yisea123/WK_JZQ_V2.7/doc/蜂鸣器播放旋律编写说明.txt

每一个音符用大括号括起来，第一个参数表示音高，第二个参数表示音长，中间用逗号隔开
如：{3,1/1},表示音调是3，音长是一个节拍
如：{2,1/4},表示音调是2，音长是四分之一个节拍，最短支持八分之一个节拍
支持一个高8度和一个低8度
如：{1~,2/1},表示音调是高音1，音长是两个节拍
如：{7_,3/4},表示音调是低音7，音长是四分之三个节拍
支持停顿，
如：{0,1/1},表示停顿一个节拍

本文件夹中"beep.txt"文件是蜂鸣器音乐的示例文件
把该文件复制到SD卡的根目录下
用脚本调用 run_beep("0:/beep.txt") 即可播放月光
用脚本调用 run_beep("0:/weizhuang.txt") 即可播放伪装
用脚本调用 run_beep("0:/juhuatai.txt") 即可播放菊花台
