yisea123/WK_JZQ_V2.7/doc/温控集中器.pdf

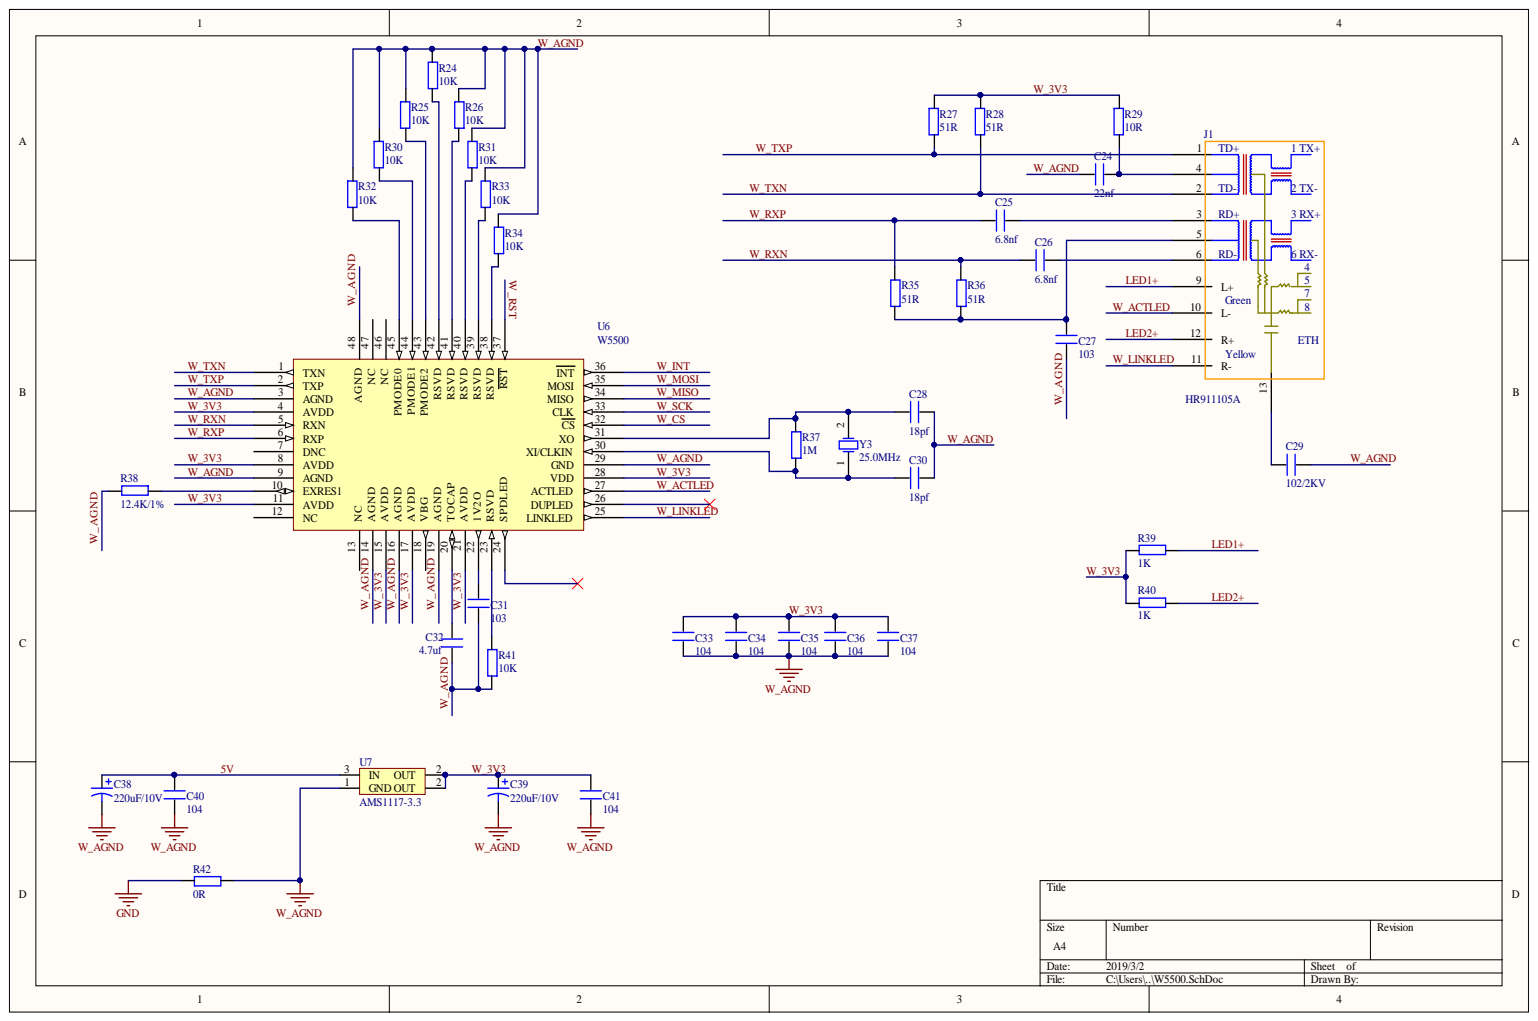
[picture p1: page 1]

6 | RD-

LED1+ W_ACTLED | | L+ 9 L- 10 R+ 12 R- 11 | 4

RST 37 RSVD 38 RSVD 39 RSVD 40 RSVD 41 RSVD 42 PMODE2 43 PMODE1 44 PMODE0 45 NC 46 NC 47 AGND 48

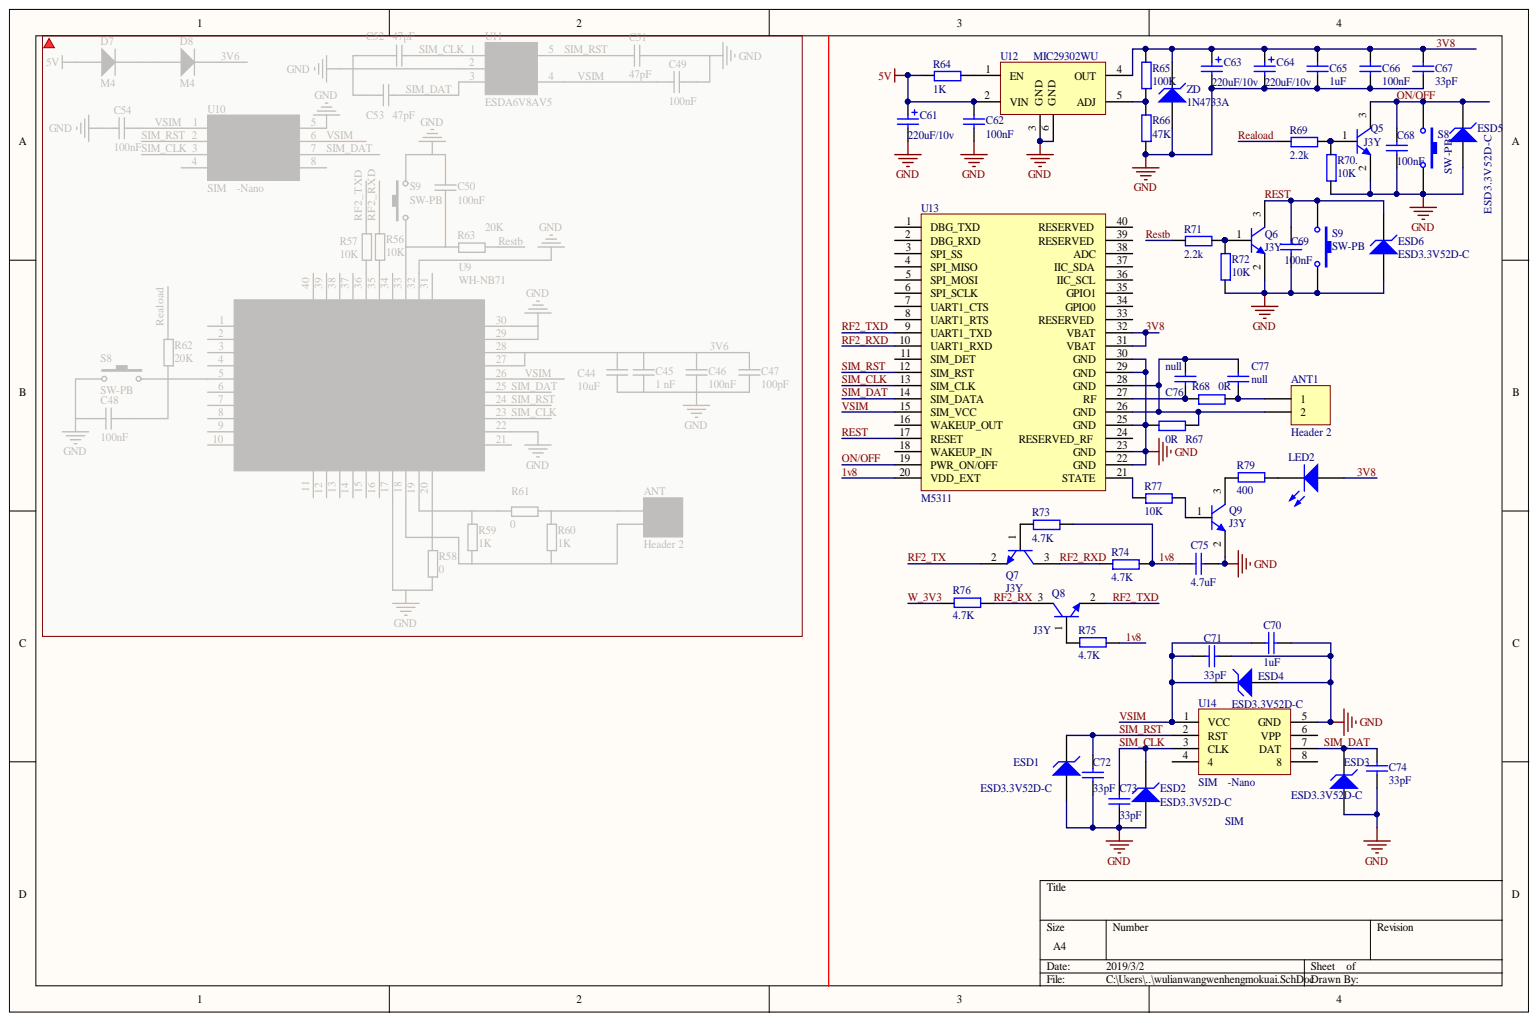
[picture p2: page 2]

2 2 | VSIM | C49

U9
WH-NB71 GND

PIO11 4 | | VSIM | C45 | C46

PIO20 6
PIO21 7 | SIM_RST
NC 8 | SIM_CLK

33pF ESD4

U14 ESD3.3V52D-C

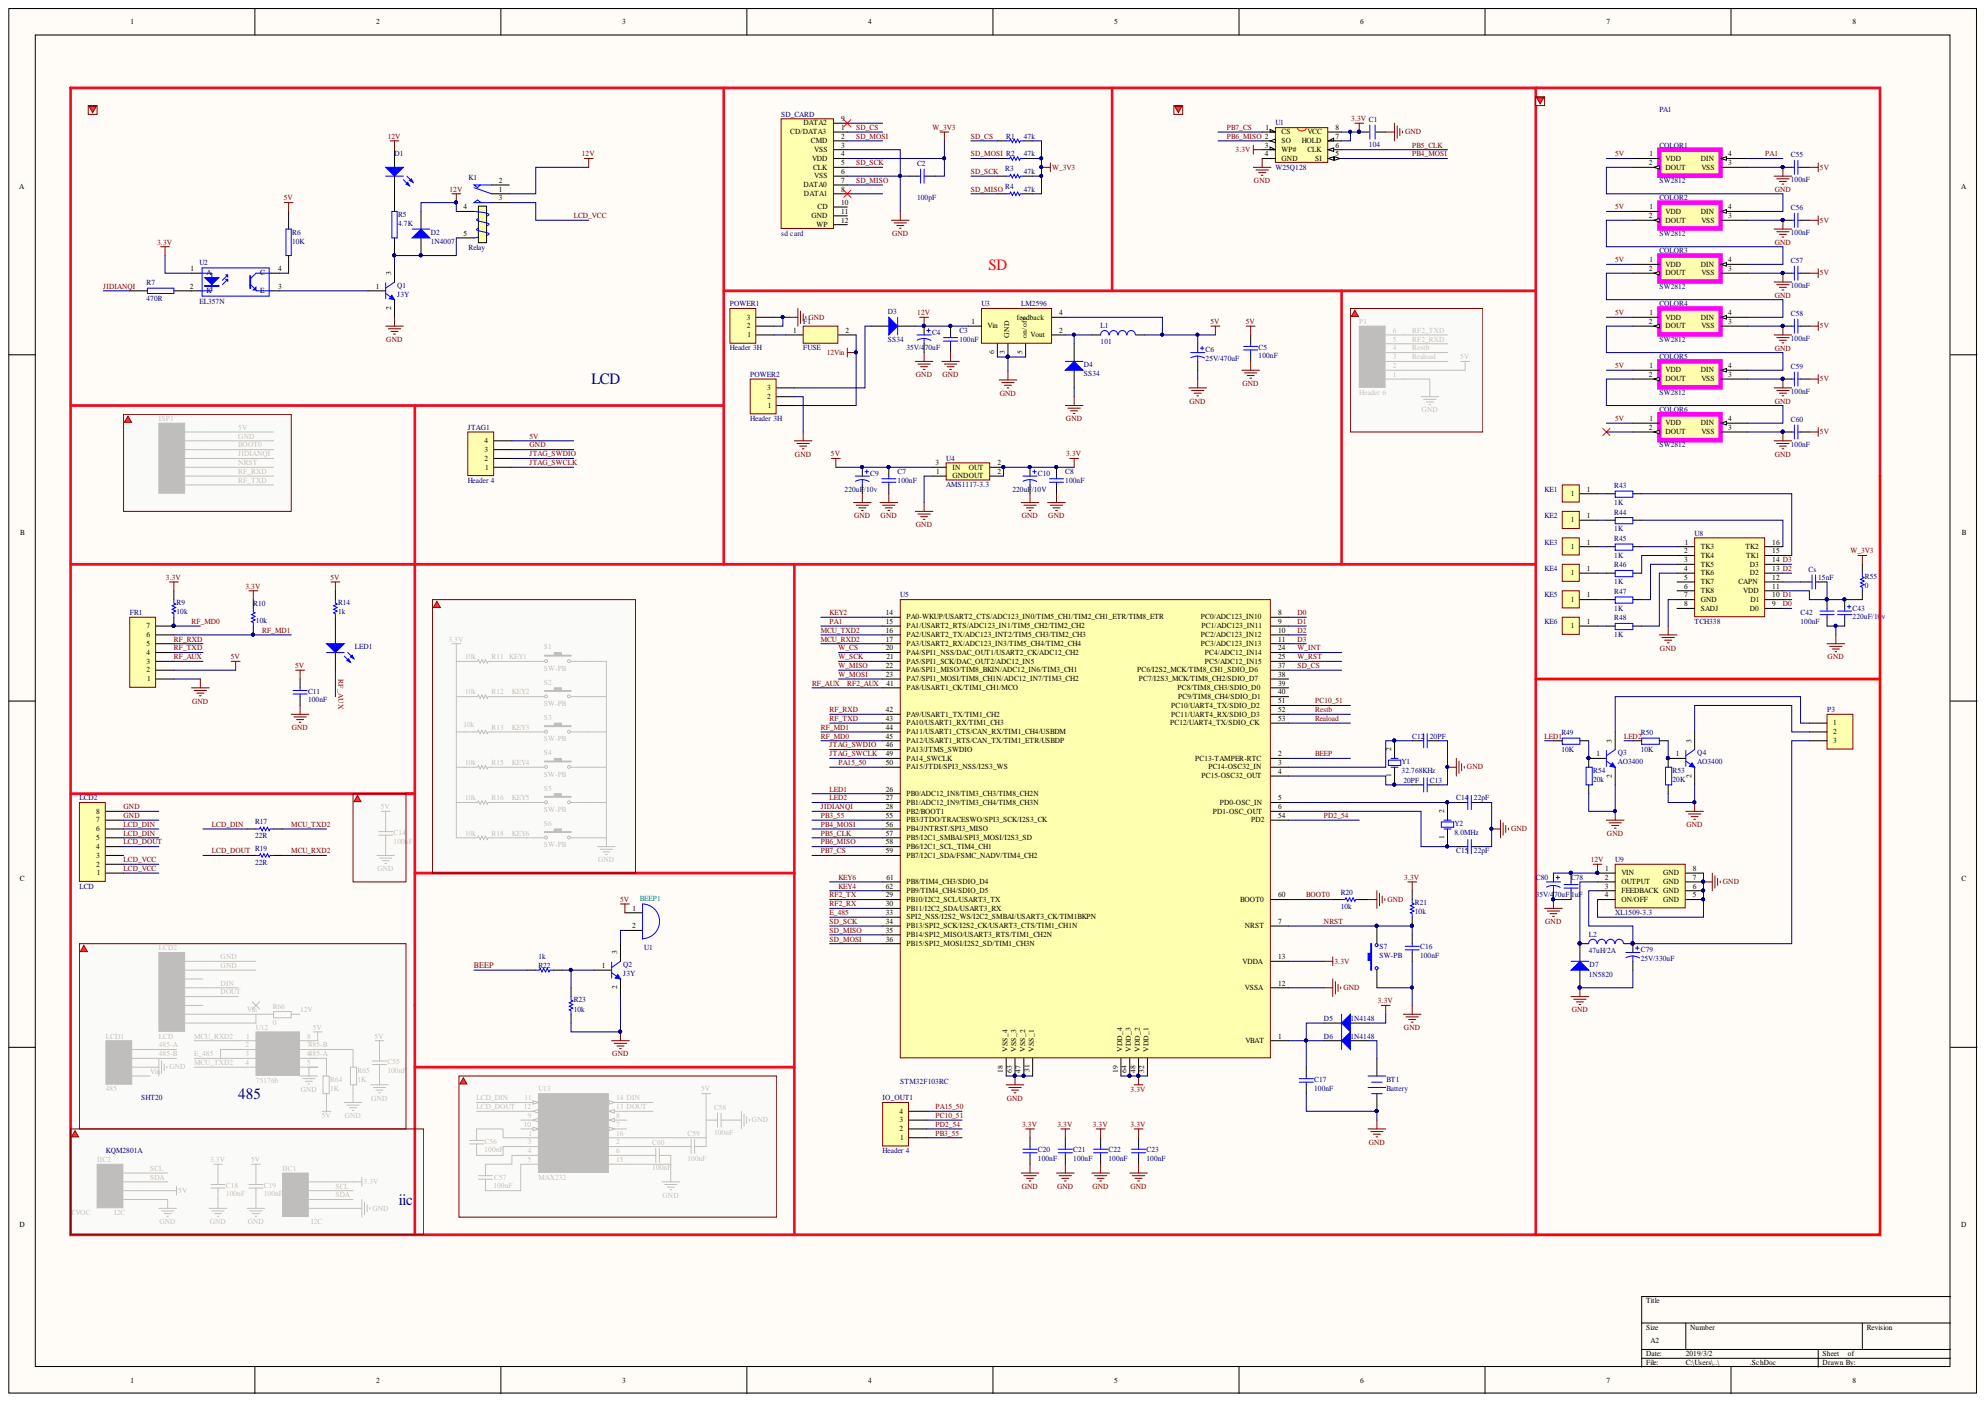
[picture p3: page 3]

TK4 2
TK5 3 | D3 D2

GND 7 | D1
