yisea123/WK_JZQ_V2.7/HARDWARE/W5500/W5500.c

/**********************************************************************************
 * 文件名  ：W5500.c
 * 描述    ：W5500 驱动函数库         
 * 库版本  ：ST_v3.5
 * 更新说明：重新整理网络部分，这个文件只提供硬件操作，2018.12.7
 * 中断优先级：2,2
 * 淘宝    ：http://yixindianzikeji.taobao.com/
**********************************************************************************/
#include "includes.h"
#include "hard_irq.h"
#include "W5500.h"	



/***************----- 网络参数变量定义 -----***************/

u8 Phy_Addr[6]={0};//硬件地址

/***************----- 端口的运行模式 -----***************/
#define TCP_SERVER	0x00	//TCP服务器模式
#define TCP_CLIENT	0x01	//TCP客户端模式 
#define UDP_MODE	0x02	//UDP(广播)模式 

/***************----- 端口的运行状态 -----***************/
#define S_INIT		0x01	//端口完成初始化 
#define S_CONN		0x02	//端口完成连接,可以正常传输数据 

/***************----- 端口收发数据的状态 -----***************/
#define S_RECEIVE	 0x01	//端口接收到一个数据包 
#define S_TRANSMITOK 0x02	//端口发送一个数据包完成 

/***************----- 端口数据缓冲区 -----***************/


/*******************************************************************************
* 函数名  : W5500_GPIO_Configuration
* 描述    : W5500 GPIO初始化配置
* 输入    : 无
* 输出    : 无
* 返回值  : 无
* 说明    : 无
*******************************************************************************/
void W5500_GPIO_Configuration(void)
{
	OS_ENTER_ONLYME();
	GPIO_InitTypeDef  GPIO_InitStructure;
	EXTI_InitTypeDef  EXTI_InitStructure;	
	NVIC_InitTypeDef NVIC_InitStructure;

	/* W5500_RST引脚初始化配置(PC5) */
	GPIO_InitStructure.GPIO_Pin  = W5500_RST;
	GPIO_InitStructure.GPIO_Speed=GPIO_Speed_10MHz;
	GPIO_InitStructure.GPIO_Mode = GPIO_Mode_Out_PP;
	GPIO_Init(W5500_RST_PORT, &GPIO_InitStructure);
	GPIO_ResetBits(W5500_RST_PORT, W5500_RST);
	
	/* W5500_INT引脚初始化配置(PC4) */	
	GPIO_InitStructure.GPIO_Pin = W5500_INT;
	GPIO_InitStructure.GPIO_Speed=GPIO_Speed_50MHz;
	GPIO_InitStructure.GPIO_Mode = GPIO_Mode_IPU;
	GPIO_Init(W5500_INT_PORT, &GPIO_InitStructure);
		
	/* Connect EXTI Line4 to PC4 */
	GPIO_EXTILineConfig(GPIO_PortSourceGPIOC, GPIO_PinSource4);

	/* PC4 as W5500 interrupt input */
	EXTI_InitStructure.EXTI_Line = EXTI_Line4;
	EXTI_InitStructure.EXTI_Mode = EXTI_Mode_Interrupt;
	EXTI_InitStructure.EXTI_Trigger = EXTI_Trigger_Falling;
	EXTI_InitStructure.EXTI_LineCmd = ENABLE;
	EXTI_Init(&EXTI_InitStructure);
	NVIC_InitStructure.NVIC_IRQChannel = EXTI4_IRQn;			//使能按键WK_UP所在的外部中断通道
	NVIC_InitStructure.NVIC_IRQChannelPreemptionPriority = 0x02;	//抢占优先级2， 
	NVIC_InitStructure.NVIC_IRQChannelSubPriority = 0x02;					//子优先级3
	NVIC_InitStructure.NVIC_IRQChannelCmd = ENABLE;								//使能外部中断通道
	NVIC_Init(&NVIC_InitStructure); 
	OS_EXIT_ONLYME();
}

/*******************************************************************************
* 函数名  : W5500_NVIC_Configuration
* 描述    : W5500 接收引脚中断优先级设置
* 输入    : 无
* 输出    : 无
* 返回值  : 无
* 说明    : 无
*******************************************************************************/
void W5500_NVIC_Configuration(void)
{
  	NVIC_InitTypeDef NVIC_InitStructure;

	/* Enable the EXTI4 Interrupt */
	NVIC_InitStructure.NVIC_IRQChannel = EXTI4_IRQn;
	NVIC_InitStructure.NVIC_IRQChannelPreemptionPriority = 0;
	NVIC_InitStructure.NVIC_IRQChannelSubPriority = 1;
	NVIC_InitStructure.NVIC_IRQChannelCmd = ENABLE;
	NVIC_Init(&NVIC_InitStructure);
}

/*******************************************************************************
* 函数名  : EXTI4_IRQHandler
* 描述    : 中断线4中断服务函数(W5500 INT引脚中断服务函数)
* 输入    : 无
* 输出    : 无
* 返回值  : 无
* 说明    : 无

				2018.7.31 中断函数移到了my_w5500.c文件中
*******************************************************************************/

/*******************************************************************************
* 函数名  : SPI_Configuration
* 描述    : W5500 SPI初始化配置(STM32 SPI1)
* 输入    : 无
* 输出    : 无
* 返回值  : 无
* 说明    : 无
*******************************************************************************/
void SPI_Configuration(void)
{
	GPIO_InitTypeDef 	GPIO_InitStructure;
	SPI_InitTypeDef   	SPI_InitStructure;	   

  RCC_APB2PeriphClockCmd(RCC_APB2Periph_GPIOA | RCC_APB2Periph_SPI1 | RCC_APB2Periph_AFIO, ENABLE);	

	/* 初始化SCK、MISO、MOSI引脚 */
	GPIO_InitStructure.GPIO_Pin = GPIO_Pin_5 | GPIO_Pin_6 | GPIO_Pin_7;
	GPIO_InitStructure.GPIO_Speed = GPIO_Speed_50MHz;
	GPIO_InitStructure.GPIO_Mode = GPIO_Mode_AF_PP;
	GPIO_Init(GPIOA, &GPIO_InitStructure);
	GPIO_SetBits(GPIOA,GPIO_Pin_5|GPIO_Pin_6|GPIO_Pin_7);

	/* 初始化CS引脚 */
	GPIO_InitStructure.GPIO_Pin = W5500_SCS;
	GPIO_InitStructure.GPIO_Speed=GPIO_Speed_50MHz;
	GPIO_InitStructure.GPIO_Mode=GPIO_Mode_Out_PP;
	GPIO_Init(W5500_SCS_PORT, &GPIO_InitStructure);
	GPIO_SetBits(W5500_SCS_PORT, W5500_SCS);

	/* 初始化配置STM32 SPI1 */
	SPI_InitStructure.SPI_Direction=SPI_Direction_2Lines_FullDuplex;	//SPI设置为双线双向全双工
	SPI_InitStructure.SPI_Mode=SPI_Mode_Master;							//设置为主SPI
	SPI_InitStructure.SPI_DataSize=SPI_DataSize_8b;						//SPI发送接收8位帧结构
	SPI_InitStructure.SPI_CPOL=SPI_CPOL_Low;							//时钟悬空低
	SPI_InitStructure.SPI_CPHA=SPI_CPHA_1Edge;							//数据捕获于第1个时钟沿
	SPI_InitStructure.SPI_NSS=SPI_NSS_Soft;								//NSS由外部管脚管理
	SPI_InitStructure.SPI_BaudRatePrescaler=SPI_BaudRatePrescaler_2;	//波特率预分频值为2
	SPI_InitStructure.SPI_FirstBit=SPI_FirstBit_MSB;					//数据传输从MSB位开始
	SPI_InitStructure.SPI_CRCPolynomial=7;								//CRC多项式为7
	SPI_Init(SPI1,&SPI_InitStructure);									//根据SPI_InitStruct中指定的参数初始化外设SPI1寄存器

	SPI_Cmd(SPI1,ENABLE);	//STM32使能SPI1
}

/*******************************************************************************
* 函数名  : SPI1_Send_Byte
* 描述    : SPI1发送1个字节数据
* 输入    : dat:待发送的数据
* 输出    : 无
* 返回值  : 返回读取到的值
* 说明    : 无
*******************************************************************************/
u8 SPI1_Send_Byte(unsigned char dat)
{
	u8 retry=0;				 	
	u8 ret=0;
	OS_ENTER_ONLYME();
	while (SPI_I2S_GetFlagStatus(SPI1, SPI_I2S_FLAG_TXE) == RESET) //检查指定的SPI标志位设置与否:发送缓存空标志位
	{
		retry++;
		if(retry>200)
		{
			OS_EXIT_ONLYME();
			return 0;
		}
	}			  
	SPI_I2S_SendData(SPI1, dat); //通过外设SPIx发送一个数据
	retry=0;

	while (SPI_I2S_GetFlagStatus(SPI1, SPI_I2S_FLAG_RXNE) == RESET) //检查指定的SPI标志位设置与否:接受缓存非空标志位
	{
		retry++;
		if(retry>200)
		{
			OS_EXIT_ONLYME();
			return 0;
		}
	}	  		
	ret=SPI_I2S_ReceiveData(SPI1); //返回通过SPIx最近接收的数据					    				    
	OS_EXIT_ONLYME();
	return ret;
}

/*******************************************************************************
* 函数名  : SPI1_Send_Short
* 描述    : SPI1发送2个字节数据(16位)
* 输入    : dat:待发送的16位数据
* 输出    : 无
* 返回值  : 无
* 说明    : 无
*******************************************************************************/
void SPI1_Send_Short(unsigned short dat)
{
	OS_ENTER_ONLYME();
	SPI1_Send_Byte(dat/256);//写数据高位
	SPI1_Send_Byte(dat);	//写数据低位
	OS_EXIT_ONLYME();
}

/*******************************************************************************
* 函数名  : Write_W5500_1Byte
* 描述    : 通过SPI1向指定地址寄存器写1个字节数据
* 输入    : reg:16位寄存器地址,dat:待写入的数据
* 输出    : 无
* 返回值  : 无
* 说明    : 无
*******************************************************************************/
void Write_W5500_1Byte(unsigned short reg, unsigned char dat)
{
	OS_ENTER_ONLYME();
	GPIO_ResetBits(W5500_SCS_PORT, W5500_SCS);//置W5500的SCS为低电平

	SPI1_Send_Short(reg);//通过SPI1写16位寄存器地址
	SPI1_Send_Byte(FDM1|RWB_WRITE|COMMON_R);//通过SPI1写控制字节,1个字节数据长度,写数据,选择通用寄存器
	SPI1_Send_Byte(dat);//写1个字节数据

	GPIO_SetBits(W5500_SCS_PORT, W5500_SCS); //置W5500的SCS为高电平
	OS_EXIT_ONLYME();
}

/*******************************************************************************
* 函数名  : Write_W5500_2Byte
* 描述    : 通过SPI1向指定地址寄存器写2个字节数据
* 输入    : reg:16位寄存器地址,dat:16位待写入的数据(2个字节)
* 输出    : 无
* 返回值  : 无
* 说明    : 无
*******************************************************************************/
void Write_W5500_2Byte(unsigned short reg, unsigned short dat)
{
	OS_ENTER_ONLYME();
	GPIO_ResetBits(W5500_SCS_PORT, W5500_SCS);//置W5500的SCS为低电平
		
	SPI1_Send_Short(reg);//通过SPI1写16位寄存器地址
	SPI1_Send_Byte(FDM2|RWB_WRITE|COMMON_R);//通过SPI1写控制字节,2个字节数据长度,写数据,选择通用寄存器
	SPI1_Send_Short(dat);//写16位数据

	GPIO_SetBits(W5500_SCS_PORT, W5500_SCS); //置W5500的SCS为高电平
	OS_EXIT_ONLYME();
}

/*******************************************************************************
* 函数名  : Write_W5500_nByte
* 描述    : 通过SPI1向指定地址寄存器写n个字节数据
* 输入    : reg:16位寄存器地址,*dat_ptr:待写入数据缓冲区指针,size:待写入的数据长度
* 输出    : 无
* 返回值  : 无
* 说明    : 无
*******************************************************************************/
void Write_W5500_nByte(unsigned short reg, unsigned char *dat_ptr, unsigned short size)
{
	unsigned short i;

	OS_ENTER_ONLYME();
	GPIO_ResetBits(W5500_SCS_PORT, W5500_SCS);//置W5500的SCS为低电平	
		
	SPI1_Send_Short(reg);//通过SPI1写16位寄存器地址
	SPI1_Send_Byte(VDM|RWB_WRITE|COMMON_R);//通过SPI1写控制字节,N个字节数据长度,写数据,选择通用寄存器

	for(i=0;i<size;i++)//循环将缓冲区的size个字节数据写入W5500
	{
		SPI1_Send_Byte(*dat_ptr++);//写一个字节数据
	}

	GPIO_SetBits(W5500_SCS_PORT, W5500_SCS); //置W5500的SCS为高电平
	OS_EXIT_ONLYME();
}

/*******************************************************************************
* 函数名  : Write_W5500_SOCK_1Byte
* 描述    : 通过SPI1向指定端口寄存器写1个字节数据
* 输入    : s:端口号,reg:16位寄存器地址,dat:待写入的数据
* 输出    : 无
* 返回值  : 无
* 说明    : 无
*******************************************************************************/
void Write_W5500_SOCK_1Byte(SOCKET s, unsigned short reg, unsigned char dat)
{ 
	OS_ENTER_ONLYME();
	GPIO_ResetBits(W5500_SCS_PORT, W5500_SCS);//置W5500的SCS为低电平	
		
	SPI1_Send_Short(reg);//通过SPI1写16位寄存器地址
	SPI1_Send_Byte(FDM1|RWB_WRITE|(s*0x20+0x08));//通过SPI1写控制字节,1个字节数据长度,写数据,选择端口s的寄存器
	SPI1_Send_Byte(dat);//写1个字节数据

	GPIO_SetBits(W5500_SCS_PORT, W5500_SCS); //置W5500的SCS为高电平
	OS_EXIT_ONLYME();
}

/*******************************************************************************
* 函数名  : Write_W5500_SOCK_2Byte
* 描述    : 通过SPI1向指定端口寄存器写2个字节数据
* 输入    : s:端口号,reg:16位寄存器地址,dat:16位待写入的数据(2个字节)
* 输出    : 无
* 返回值  : 无
* 说明    : 无
*******************************************************************************/
void Write_W5500_SOCK_2Byte(SOCKET s, unsigned short reg, unsigned short dat)
{
	OS_ENTER_ONLYME();
	GPIO_ResetBits(W5500_SCS_PORT, W5500_SCS);//置W5500的SCS为低电平
			
	SPI1_Send_Short(reg);//通过SPI1写16位寄存器地址
	SPI1_Send_Byte(FDM2|RWB_WRITE|(s*0x20+0x08));//通过SPI1写控制字节,2个字节数据长度,写数据,选择端口s的寄存器
	SPI1_Send_Short(dat);//写16位数据

	GPIO_SetBits(W5500_SCS_PORT, W5500_SCS); //置W5500的SCS为高电平
	OS_EXIT_ONLYME();
}

/*******************************************************************************
* 函数名  : Write_W5500_SOCK_4Byte
* 描述    : 通过SPI1向指定端口寄存器写4个字节数据
* 输入    : s:端口号,reg:16位寄存器地址,*dat_ptr:待写入的4个字节缓冲区指针
* 输出    : 无
* 返回值  : 无
* 说明    : 无
*******************************************************************************/
void Write_W5500_SOCK_4Byte(SOCKET s, unsigned short reg, unsigned char *dat_ptr)
{
	OS_ENTER_ONLYME();
	GPIO_ResetBits(W5500_SCS_PORT, W5500_SCS);//置W5500的SCS为低电平
			
	SPI1_Send_Short(reg);//通过SPI1写16位寄存器地址
	SPI1_Send_Byte(FDM4|RWB_WRITE|(s*0x20+0x08));//通过SPI1写控制字节,4个字节数据长度,写数据,选择端口s的寄存器

	SPI1_Send_Byte(*dat_ptr++);//写第1个字节数据
	SPI1_Send_Byte(*dat_ptr++);//写第2个字节数据
	SPI1_Send_Byte(*dat_ptr++);//写第3个字节数据
	SPI1_Send_Byte(*dat_ptr++);//写第4个字节数据

	GPIO_SetBits(W5500_SCS_PORT, W5500_SCS); //置W5500的SCS为高电平
	OS_EXIT_ONLYME();
}

/*******************************************************************************
* 函数名  : Read_W5500_1Byte
* 描述    : 读W5500指定地址寄存器的1个字节数据
* 输入    : reg:16位寄存器地址
* 输出    : 无
* 返回值  : 读取到寄存器的1个字节数据
* 说明    : 无
*******************************************************************************/
unsigned char Read_W5500_1Byte(unsigned short reg)
{
	unsigned char i;

	OS_ENTER_ONLYME();
	GPIO_ResetBits(W5500_SCS_PORT, W5500_SCS);//置W5500的SCS为低电平
			
	SPI1_Send_Short(reg);//通过SPI1写16位寄存器地址
	i=SPI1_Send_Byte(FDM1|RWB_READ|COMMON_R);//通过SPI1写控制字节,1个字节数据长度,读数据,选择通用寄存器

	i=SPI1_Send_Byte(0x00);//发送一个哑数据

	GPIO_SetBits(W5500_SCS_PORT, W5500_SCS);//置W5500的SCS为高电平
	OS_EXIT_ONLYME();
	return i;//返回读取到的寄存器数据
}


/*******************************************************************************
* 函数名  : Read_W5500_nByte
* 描述    : 通过SPI1向指定地址寄存器读n个字节数据
* 输入    : reg:16位寄存器地址,*dat_ptr:待写入数据缓冲区指针,size:待写入的数据长度
* 输出    : 无
* 返回值  : 无
* 说明    : 无
*******************************************************************************/
void Read_W5500_nByte(unsigned short reg, unsigned char *dat_ptr, unsigned short size)
{
	unsigned short i;

	OS_ENTER_ONLYME();
	GPIO_ResetBits(W5500_SCS_PORT, W5500_SCS);//置W5500的SCS为低电平	
		
	SPI1_Send_Short(reg);//通过SPI1写16位寄存器地址
	SPI1_Send_Byte(VDM|RWB_READ|COMMON_R);//通过SPI1写控制字节,N个字节数据长度,写数据,选择通用寄存器

	for(i=0;i<size;i++)//循环将缓冲区的size个字节数据写入W5500
	{
		*dat_ptr++=SPI1_Send_Byte(0);//写一个字节数据
	}

	GPIO_SetBits(W5500_SCS_PORT, W5500_SCS); //置W5500的SCS为高电平
	OS_EXIT_ONLYME();
}

/*******************************************************************************
* 函数名  : Read_W5500_SOCK_1Byte
* 描述    : 读W5500指定端口寄存器的1个字节数据
* 输入    : s:端口号,reg:16位寄存器地址
* 输出    : 无
* 返回值  : 读取到寄存器的1个字节数据
* 说明    : 无
*******************************************************************************/
unsigned char Read_W5500_SOCK_1Byte(SOCKET s, unsigned short reg)
{
	unsigned char i;

	OS_ENTER_ONLYME();
	GPIO_ResetBits(W5500_SCS_PORT, W5500_SCS);//置W5500的SCS为低电平
			
	SPI1_Send_Short(reg);//通过SPI1写16位寄存器地址
	i=SPI1_Send_Byte(FDM1|RWB_READ|(s*0x20+0x08));//通过SPI1写控制字节,1个字节数据长度,读数据,选择端口s的寄存器

	i=SPI1_Send_Byte(0x00);//发送一个哑数据

	GPIO_SetBits(W5500_SCS_PORT, W5500_SCS);//置W5500的SCS为高电平
	OS_EXIT_ONLYME();
	return i;//返回读取到的寄存器数据
}

/*******************************************************************************
* 函数名  : Read_W5500_SOCK_2Byte
* 描述    : 读W5500指定端口寄存器的2个字节数据
* 输入    : s:端口号,reg:16位寄存器地址
* 输出    : 无
* 返回值  : 读取到寄存器的2个字节数据(16位)
* 说明    : 无
*******************************************************************************/
unsigned short Read_W5500_SOCK_2Byte(SOCKET s, unsigned short reg)
{
	unsigned short i;

	OS_ENTER_ONLYME();
	GPIO_ResetBits(W5500_SCS_PORT, W5500_SCS);//置W5500的SCS为低电平
			
	SPI1_Send_Short(reg);//通过SPI1写16位寄存器地址
	i=SPI1_Send_Byte(FDM2|RWB_READ|(s*0x20+0x08));//通过SPI1写控制字节,2个字节数据长度,读数据,选择端口s的寄存器

	i=SPI1_Send_Byte(0x00);//发送一个哑数据
	i<<=8;
	i|=SPI1_Send_Byte(0x00);//发送一个哑数据

	GPIO_SetBits(W5500_SCS_PORT, W5500_SCS);//置W5500的SCS为高电平
	OS_EXIT_ONLYME();
	return i;//返回读取到的寄存器数据
}

/*******************************************************************************
* 函数名  : Read_SOCK_Data_Buffer
* 描述    : 从W5500接收数据缓冲区中读取数据
* 输入    : s:端口号,*dat_ptr:数据保存缓冲区指针
* 输出    : 无
* 返回值  : 读取到的数据长度,rx_size个字节
* 说明    : 无
*******************************************************************************/
unsigned short Read_SOCK_Data_Buffer(SOCKET s, unsigned char *dat_ptr)
{
	unsigned short rx_size;
	unsigned short offset, offset1;
	unsigned short i;
	unsigned char j;
	
	OS_ENTER_ONLYME();

	rx_size=Read_W5500_SOCK_2Byte(s,Sn_RX_RSR);
	if(rx_size==0) 
	{
		OS_EXIT_ONLYME();
		return 0;//没接收到数据则返回
	}
	if(rx_size>1460) rx_size=1460;

	offset=Read_W5500_SOCK_2Byte(s,Sn_RX_RD);
	offset1=offset;
	offset&=(S_RX_SIZE-1);//计算实际的物理地址

	GPIO_ResetBits(W5500_SCS_PORT, W5500_SCS);//置W5500的SCS为低电平

	SPI1_Send_Short(offset);//写16位地址
	j=SPI1_Send_Byte(VDM|RWB_READ|(s*0x20+0x18));//写控制字节,N个字节数据长度,读数据,选择端口s的寄存器
	
	if((offset+rx_size)<S_RX_SIZE)//如果最大地址未超过W5500接收缓冲区寄存器的最大地址
	{
		for(i=0;i<rx_size;i++)//循环读取rx_size个字节数据
		{
			j=SPI1_Send_Byte(0x00);//发送一个哑数据
			*dat_ptr=j;//将读取到的数据保存到数据保存缓冲区
			dat_ptr++;//数据保存缓冲区指针地址自增1
		}
	}
	else//如果最大地址超过W5500接收缓冲区寄存器的最大地址
	{
		offset=S_RX_SIZE-offset;
		for(i=0;i<offset;i++)//循环读取出前offset个字节数据
		{
			j=SPI1_Send_Byte(0x00);//发送一个哑数据
			*dat_ptr=j;//将读取到的数据保存到数据保存缓冲区
			dat_ptr++;//数据保存缓冲区指针地址自增1
		}
		GPIO_SetBits(W5500_SCS_PORT, W5500_SCS); //置W5500的SCS为高电平

		GPIO_ResetBits(W5500_SCS_PORT, W5500_SCS);//置W5500的SCS为低电平

		SPI1_Send_Short(0x00);//写16位地址
		j=SPI1_Send_Byte(VDM|RWB_READ|(s*0x20+0x18));//写控制字节,N个字节数据长度,读数据,选择端口s的寄存器

		for(;i<rx_size;i++)//循环读取后rx_size-offset个字节数据
		{
			j=SPI1_Send_Byte(0x00);//发送一个哑数据
			*dat_ptr=j;//将读取到的数据保存到数据保存缓冲区
			dat_ptr++;//数据保存缓冲区指针地址自增1
		}
	}
	GPIO_SetBits(W5500_SCS_PORT, W5500_SCS); //置W5500的SCS为高电平

	offset1+=rx_size;//更新实际物理地址,即下次读取接收到的数据的起始地址
	Write_W5500_SOCK_2Byte(s, Sn_RX_RD, offset1);
	Write_W5500_SOCK_1Byte(s, Sn_CR, SN_RECV);//发送启动接收命令
	
	OS_EXIT_ONLYME();
	return rx_size;//返回接收到数据的长度
}

/*******************************************************************************
* 函数名  : Write_SOCK_Data_Buffer
* 描述    : 将数据写入W5500的数据发送缓冲区
* 输入    : s:端口号,*dat_ptr:数据保存缓冲区指针,size:待写入数据的长度
* 输出    : 无
* 返回值  : 无
* 说明    : 无
*******************************************************************************/
void Write_SOCK_Data_Buffer(SOCKET s, unsigned char *dat_ptr, unsigned short size)
{
	unsigned short offset,offset1;
	unsigned short i;

	OS_ENTER_ONLYME();

	offset=Read_W5500_SOCK_2Byte(s,Sn_TX_WR);
	offset1=offset;
	offset&=(S_TX_SIZE-1);//计算实际的物理地址

	GPIO_ResetBits(W5500_SCS_PORT, W5500_SCS);//置W5500的SCS为低电平

	SPI1_Send_Short(offset);//写16位地址
	SPI1_Send_Byte(VDM|RWB_WRITE|(s*0x20+0x10));//写控制字节,N个字节数据长度,写数据,选择端口s的寄存器

	if((offset+size)<S_TX_SIZE)//如果最大地址未超过W5500发送缓冲区寄存器的最大地址
	{
		for(i=0;i<size;i++)//循环写入size个字节数据
		{
			SPI1_Send_Byte(*dat_ptr++);//写入一个字节的数据		
		}
		
	}
	else//如果最大地址超过W5500发送缓冲区寄存器的最大地址
	{
		offset=S_TX_SIZE-offset;
		for(i=0;i<offset;i++)//循环写入前offset个字节数据
		{
			SPI1_Send_Byte(*dat_ptr++);//写入一个字节的数据
		}
		GPIO_SetBits(W5500_SCS_PORT, W5500_SCS); //置W5500的SCS为高电平

		GPIO_ResetBits(W5500_SCS_PORT, W5500_SCS);//置W5500的SCS为低电平

		SPI1_Send_Short(0x00);//写16位地址
		SPI1_Send_Byte(VDM|RWB_WRITE|(s*0x20+0x10));//写控制字节,N个字节数据长度,写数据,选择端口s的寄存器

		for(;i<size;i++)//循环写入size-offset个字节数据
		{
			SPI1_Send_Byte(*dat_ptr++);//写入一个字节的数据
		}
	}
	GPIO_SetBits(W5500_SCS_PORT, W5500_SCS); //置W5500的SCS为高电平

	offset1+=size;//更新实际物理地址,即下次写待发送数据到发送数据缓冲区的起始地址
	Write_W5500_SOCK_2Byte(s, Sn_TX_WR, offset1);
	Write_W5500_SOCK_1Byte(s, Sn_CR, SN_SEND);//发送启动发送命令				
	OS_EXIT_ONLYME();
}

/*******************************************************************************
* 函数名  : W5500_Hardware_Reset
* 描述    : 硬件复位W5500
* 输入    : 无
* 输出    : 无
* 返回值  : 无
* 说明    : W5500的复位引脚保持低电平至少500us以上,才能重围W5500
*******************************************************************************/
void W5500_Hardware_Reset(void)
{
	GPIO_ResetBits(W5500_RST_PORT, W5500_RST);//复位引脚拉低
	Delay(500);
	GPIO_SetBits(W5500_RST_PORT, W5500_RST);//复位引脚拉高
	Delay(200);
	while((Read_W5500_1Byte(PHYCFGR)&LINK)==0)
	{
		Delay(200);
		
	}//等待以太网连接完成
}

/*******************************************************************************
* 函数名  : W5500_Init
* 描述    : 初始化W5500寄存器函数
* 输入    : 无
* 输出    : 无
* 返回值  : 无
* 说明    : 在使用W5500之前，先对W5500初始化
*******************************************************************************/
void W5500_Init(void)
{
	u8 i=0;

	Write_W5500_1Byte(MR, RST);//软件复位W5500,置1有效,复位后自动清0
	Delay(10);//延时10ms,自己定义该函数

	//设置MAC地址到W5500
	Write_W5500_nByte(SHAR,Phy_Addr,6);		

	
	//设置发送缓冲区和接收缓冲区的大小，参考W5500数据手册
	for(i=0;i<8;i++)
	{
		Write_W5500_SOCK_1Byte(i,Sn_RXBUF_SIZE, 0x02);//Socket Rx memory size=2k
		Write_W5500_SOCK_1Byte(i,Sn_TXBUF_SIZE, 0x02);//Socket Tx mempry size=2k
	}

	//设置重试时间，默认为2000(200ms) 
	//每一单位数值为100微秒,初始化时值设为2000，等于200毫秒
	Write_W5500_2Byte(RTR, 2000);

	//设置重试次数，默认为8次 
	//如果重发的次数超过设定值,则产生超时中断(相关的端口中断寄存器中的Sn_IR 超时位(TIMEOUT)置“1”)
	Write_W5500_1Byte(RCR,8);

	//启动中断，参考W5500数据手册确定自己需要的中断类型
	//IMR_CONFLICT是IP地址冲突异常中断,IMR_UNREACH是UDP通信时，地址无法到达的异常中断
	//其它是Socket事件中断，根据需要添加
	Write_W5500_1Byte(IMR,IM_IR7 | IM_IR6);
	Write_W5500_1Byte(SIMR,S0_IMR|S1_IMR|S2_IMR|S3_IMR|S4_IMR|S5_IMR|S6_IMR|S7_IMR);
	Write_W5500_SOCK_1Byte(0, Sn_IMR, IMR_SENDOK | IMR_TIMEOUT | IMR_RECV | IMR_DISCON | IMR_CON);
	Write_W5500_SOCK_1Byte(1, Sn_IMR, IMR_SENDOK | IMR_TIMEOUT | IMR_RECV | IMR_DISCON | IMR_CON);
	Write_W5500_SOCK_1Byte(2, Sn_IMR, IMR_SENDOK | IMR_TIMEOUT | IMR_RECV | IMR_DISCON | IMR_CON);
	Write_W5500_SOCK_1Byte(3, Sn_IMR, IMR_SENDOK | IMR_TIMEOUT | IMR_RECV | IMR_DISCON | IMR_CON);
	Write_W5500_SOCK_1Byte(4, Sn_IMR, IMR_SENDOK | IMR_TIMEOUT | IMR_RECV | IMR_DISCON | IMR_CON);
	Write_W5500_SOCK_1Byte(5, Sn_IMR, IMR_SENDOK | IMR_TIMEOUT | IMR_RECV | IMR_DISCON | IMR_CON);
	Write_W5500_SOCK_1Byte(6, Sn_IMR, IMR_SENDOK | IMR_TIMEOUT | IMR_RECV | IMR_DISCON | IMR_CON);
	Write_W5500_SOCK_1Byte(7, Sn_IMR, IMR_SENDOK | IMR_TIMEOUT | IMR_RECV | IMR_DISCON | IMR_CON);
}

/*******************************************************************************
* 函数名  : Socket_Init
* 描述    : 指定Socket(0~7)初始化
* 输入    : s:待初始化的端口
* 输出    : 无
* 返回值  : 无
* 说明    : 无
*******************************************************************************/
void Socket_Init(SOCKET s)
{
	//设置分片长度，参考W5500数据手册，该值可以不修改	
	Write_W5500_SOCK_2Byte(0, Sn_MSSR, 1460);//最大分片字节数=1460(0x5b4)
	Write_W5500_SOCK_2Byte(1, Sn_MSSR, 1460);//最大分片字节数=1460(0x5b4)
	Write_W5500_SOCK_2Byte(2, Sn_MSSR, 1460);//最大分片字节数=1460(0x5b4)
	Write_W5500_SOCK_2Byte(3, Sn_MSSR, 1460);//最大分片字节数=1460(0x5b4)
	Write_W5500_SOCK_2Byte(4, Sn_MSSR, 1460);//最大分片字节数=1460(0x5b4)
	Write_W5500_SOCK_2Byte(5, Sn_MSSR, 1460);//最大分片字节数=1460(0x5b4)
	Write_W5500_SOCK_2Byte(6, Sn_MSSR, 1460);//最大分片字节数=1460(0x5b4)
	Write_W5500_SOCK_2Byte(7, Sn_MSSR, 1460);//最大分片字节数=1460(0x5b4)
}

/*******************************************************************************
* 函数名  : Socket_Connect
* 描述    : 设置指定Socket(0~7)为客户端与远程服务器连接
* 输入    : s:待设定的端口
* 输出    : 无
* 返回值  : 成功返回TRUE(0xFF),失败返回FALSE(0x00)
* 说明    : 当本机Socket工作在客户端模式时,引用该程序,与远程服务器建立连接
*			如果启动连接后出现超时中断，则与服务器连接失败,需要重新调用该程序连接
*			该程序每调用一次,就与服务器产生一次连接
*******************************************************************************/
unsigned char Socket_Connect(SOCKET s)
{
	Write_W5500_SOCK_1Byte(s,Sn_MR,MR_TCP);//设置socket为TCP模式
	Write_W5500_SOCK_1Byte(s,Sn_CR,SN_OPEN);//打开Socket
	Delay(5);//延时5ms
	if(Read_W5500_SOCK_1Byte(s,Sn_SR)!=SOCK_INIT)//如果socket打开失败
	{
		Write_W5500_SOCK_1Byte(s,Sn_CR,SN_CLOSE);//打开不成功,关闭Socket
		return FALSE;//返回FALSE(0x00)
	}
	Write_W5500_SOCK_1Byte(s,Sn_CR,SN_CONNECT);//设置Socket为Connect模式
	return TRUE;//返回TRUE,设置成功
}

/*******************************************************************************
* 函数名  : Socket_Listen
* 描述    : 设置指定Socket(0~7)作为服务器等待远程主机的连接
* 输入    : s:待设定的端口
* 输出    : 无
* 返回值  : 成功返回TRUE(0xFF),失败返回FALSE(0x00)
* 说明    : 当本机Socket工作在服务器模式时,引用该程序,等等远程主机的连接
*			该程序只调用一次,就使W5500设置为服务器模式
*******************************************************************************/
unsigned char Socket_Listen(SOCKET s)
{
	Write_W5500_SOCK_1Byte(s,Sn_MR,MR_TCP);//设置socket为TCP模式 
	Write_W5500_SOCK_1Byte(s,Sn_CR,SN_OPEN);//打开Socket	
	Delay(5);//延时5ms
	if(Read_W5500_SOCK_1Byte(s,Sn_SR)!=SOCK_INIT)//如果socket打开失败
	{
		Write_W5500_SOCK_1Byte(s,Sn_CR,SN_CLOSE);//打开不成功,关闭Socket
		return FALSE;//返回FALSE(0x00)
	}	
	Write_W5500_SOCK_1Byte(s,Sn_CR,SN_LISTEN);//设置Socket为侦听模式	
	Delay(5);//延时5ms
	if(Read_W5500_SOCK_1Byte(s,Sn_SR)!=SOCK_LISTEN)//如果socket设置失败
	{
		Write_W5500_SOCK_1Byte(s,Sn_CR,SN_CLOSE);//设置不成功,关闭Socket
		return FALSE;//返回FALSE(0x00)
	}

	return TRUE;

	//至此完成了Socket的打开和设置侦听工作,至于远程客户端是否与它建立连接,则需要等待Socket中断，
	//以判断Socket的连接是否成功。参考W5500数据手册的Socket中断状态
	//在服务器侦听模式不需要设置目的IP和目的端口号
}

/*******************************************************************************
* 函数名  : Socket_UDP
* 描述    : 设置指定Socket(0~7)为UDP模式
* 输入    : s:待设定的端口
* 输出    : 无
* 返回值  : 成功返回TRUE(0xFF),失败返回FALSE(0x00)
* 说明    : 如果Socket工作在UDP模式,引用该程序,在UDP模式下,Socket通信不需要建立连接
*			该程序只调用一次，就使W5500设置为UDP模式
*******************************************************************************/
unsigned char Socket_UDP(SOCKET s)
{
	Write_W5500_SOCK_1Byte(s,Sn_MR,MR_UDP);//设置Socket为UDP模式*/
	Write_W5500_SOCK_1Byte(s,Sn_CR,SN_OPEN);//打开Socket*/
	Delay(5);//延时5ms
	if(Read_W5500_SOCK_1Byte(s,Sn_SR)!=SOCK_UDP)//如果Socket打开失败
	{
		Write_W5500_SOCK_1Byte(s,Sn_CR,SN_CLOSE);//打开不成功,关闭Socket
		return FALSE;//返回FALSE(0x00)
	}
	else
		return TRUE;

	//至此完成了Socket的打开和UDP模式设置,在这种模式下它不需要与远程主机建立连接
	//因为Socket不需要建立连接,所以在发送数据前都可以设置目的主机IP和目的Socket的端口号
	//如果目的主机IP和目的Socket的端口号是固定的,在运行过程中没有改变,那么也可以在这里设置
}

/*******************************************************************************
* 函数名  : W5500_Interrupt_Process
* 描述    : W5500中断处理程序框架
* 输入    : 无
* 输出    : 无
* 返回值  : 无
* 说明    : 无
*******************************************************************************/



/*******************************************************************************
* 函数名  : Delay
* 描述    : 延时函数(ms)
* 输入    : d:延时系数，单位为毫秒
* 输出    : 无
* 返回    : 无 
* 说明    : 延时是利用Timer2定时器产生的1毫秒的计数来实现的

2018.7.31  改为调用系统延时函数

*******************************************************************************/
void Delay(unsigned int d)
{
	delay_ms(d);
}



/*******************************************************************************
* 函数名  : W5500_Socket_Set
* 描述    : W5500端口初始化配置
* 输入    : 无
* 输出    : 无
* 返回值  : 无
* 说明    : 分别设置4个端口,根据端口工作模式,将端口置于TCP服务器、TCP客户端或UDP模式.
*			从端口状态字节Socket_State可以判断端口的工作情况
*******************************************************************************/
void W5500_Socket_Set(void)
{
}


/*******************************************************************************
* 函数名  : W5500_Initialization
* 描述    : W5500初始货配置
* 输入    : 无
* 输出    : 无
* 返回值  : 无
* 说明    : 无
*******************************************************************************/
void W5500_Initialization(void)
{
	SPI_Configuration();		//W5500 SPI初始化配置(STM32 SPI1)
	W5500_GPIO_Configuration();	//W5500 GPIO初始化配置	
	Load_Net_Parameters();		//装载MAC地址到内存
	W5500_Hardware_Reset();		//硬件复位W5500

	W5500_Init();		//初始化W5500寄存器函数，设置MAC地址等
	Socket_Init(0);		//初始化Socket参数，端口的数据分片
}








/*******************************************************************************
* 函数名  : Load_Net_Parameters
* 描述    : 装载网络参数
* 输入    : 无
* 输出    : 无
* 返回值  : 无
* 说明    : 网关、掩码、物理地址、本机IP地址、端口号、目的IP地址、目的端口号、端口工作模式
*******************************************************************************/

void Load_Net_Parameters(void)
{
	u8 data[6]={0};


	mymemcpy(Phy_Addr,MAC,6);
	mymemcpy(data,MAC+6,6);
	for (u8 i=0;i<6;i++)
	{
		Phy_Addr[i]+=data[i];
	}
	Phy_Addr[0]&=0xfe;//第一位为偶数
}


//网络状态标志位,ip地址冲突，网线没有连接等
static u8 NET_STATE=0;
static u8 NET_SOCKET_STATE[8]={0};

#define W5500_IRQ_PIN PCin(4)

//有中断就给网口任务发消息
void EXTI4_IRQHandler(void)
{
	if(EXTI_GetITStatus(EXTI_Line4) != RESET)
	{
		EXTI_ClearITPendingBit(EXTI_Line4);
		TaskIntSendMsg(0,SYS_MSG_W5500);
	}
}


//在任务中调用或者在中断中调用
void W5500_IRQ (void)
{
	u8 temp=0;u8 sntemp=0;
	do
	{
		temp = Read_W5500_1Byte(IR);//读取中断标志寄存器
//		if (temp)
//		{
//			temp = Read_W5500_1Byte(IR);//这个读取可能会出错，重读确认
//		}
		Write_W5500_1Byte(IR, (temp&0xf0));//回写清除中断标志
		NET_STATE|=temp;//保存网络状况
		temp=Read_W5500_1Byte(SIR);//读取端口中断标志寄存器	
		if((temp & S0_INT) == S0_INT)//Socket0事件处理 
		{
			sntemp=Read_W5500_SOCK_1Byte(0,Sn_IR);//读取Socket0中断标志寄存器
			Write_W5500_SOCK_1Byte(0,Sn_IR,sntemp);
			NET_SOCKET_STATE[0]|=sntemp;
			TaskIntSendMsg(0,W5500_SOCKET0);
		}
		
		if((temp & S1_INT) == S1_INT)//Socket1事件处理 
		{
			sntemp=Read_W5500_SOCK_1Byte(1,Sn_IR);//读取Socket1中断标志寄存器
			Write_W5500_SOCK_1Byte(1,Sn_IR,sntemp);
			NET_SOCKET_STATE[1]|=sntemp;
			TaskIntSendMsg(0,W5500_SOCKET1);
		}
		
		if((temp & S2_INT) == S2_INT)//Socket1事件处理 
		{
			sntemp=Read_W5500_SOCK_1Byte(2,Sn_IR);//读取Socket1中断标志寄存器
			Write_W5500_SOCK_1Byte(2,Sn_IR,sntemp);
			NET_SOCKET_STATE[2]|=sntemp;
			TaskIntSendMsg(0,W5500_SOCKET2);
		}

		if((temp & S3_INT) == S3_INT)//Socket1事件处理 
		{
			sntemp=Read_W5500_SOCK_1Byte(3,Sn_IR);//读取Socket1中断标志寄存器
			Write_W5500_SOCK_1Byte(3,Sn_IR,sntemp);
			NET_SOCKET_STATE[3]|=sntemp;
			TaskIntSendMsg(0,W5500_SOCKET3);
		}

		if((temp & S4_INT) == S4_INT)//Socket1事件处理 
		{
			sntemp=Read_W5500_SOCK_1Byte(4,Sn_IR);//读取Socket1中断标志寄存器
			Write_W5500_SOCK_1Byte(4,Sn_IR,sntemp);
			NET_SOCKET_STATE[4]|=sntemp;
			TaskIntSendMsg(0,W5500_SOCKET4);
		}

		if((temp & S5_INT) == S5_INT)//Socket1事件处理 
		{
			sntemp=Read_W5500_SOCK_1Byte(5,Sn_IR);//读取Socket1中断标志寄存器
			Write_W5500_SOCK_1Byte(5,Sn_IR,sntemp);
			NET_SOCKET_STATE[5]|=sntemp;
			TaskIntSendMsg(0,W5500_SOCKET5);
		}

		if((temp & S6_INT) == S6_INT)//Socket1事件处理 
		{
			sntemp=Read_W5500_SOCK_1Byte(6,Sn_IR);//读取Socket1中断标志寄存器
			Write_W5500_SOCK_1Byte(6,Sn_IR,sntemp);
			NET_SOCKET_STATE[6]|=sntemp;
			TaskIntSendMsg(0,W5500_SOCKET6);
		}

		if((temp & S7_INT) == S7_INT)//Socket1事件处理 
		{
			sntemp=Read_W5500_SOCK_1Byte(7,Sn_IR);//读取Socket1中断标志寄存器
			Write_W5500_SOCK_1Byte(7,Sn_IR,sntemp);
			NET_SOCKET_STATE[7]|=sntemp;
			TaskIntSendMsg(0,W5500_SOCKET7);
		}
	}while (W5500_IRQ_PIN==0);
	//while(Read_W5500_1Byte(SIR) != 0) ;
}












//获取指定端口的状态
u8 getSocketState (u8 socket)
{
	return NET_SOCKET_STATE[socket];
}

//清除指定端口的状态
void delSocketState (u8 socket,u8 states)
{
	NET_SOCKET_STATE[socket]&=~states;
}


//查询网络是否有指定状态，有则返回1,并清除，无返回0
u8 checkSocketState (u8 socket,u8 state)
{
	if (NET_SOCKET_STATE[socket]&state)
	{
		NET_SOCKET_STATE[socket]&=~state;
		return 1;
	}
	else
	{
		return 0;
	}
}

//查询网络状况
u8 checkNetstate (u8 state)
{
	if (NET_STATE&state)
	{
		NET_STATE&=~state;
		return 1;
	}
	else
	{
		return 0;
	}

}

//查询网络状况,不清除
u8 checkNetstateN (u8 state)
{
	if (NET_STATE&state)
	{
		return 1;
	}
	else
	{
		return 0;
	}

}



//查询网络是否有指定状态，有则返回1,，无返回0
u8 checkSocketStateN (u8 socket,u8 state)
{
	if (NET_SOCKET_STATE[socket]&state)
	{
		return 1;
	}
	else
	{
		return 0;
	}
}
