yisea123/WK_JZQ_V2.7/SOFTWARE/DATA_TYPE/data_type.c

#include "includes.h"
#include "data_type.h"



/********************************

		这个文件定义使用动态分配内存的数据类型

***********************************/


//获取系统配置文件,返回0失败
u8 load_sys_cfg(SysCfgDef *buff)
{ 
	if ((SPI_FLASH_TYPE==W25Q80)||(SPI_FLASH_TYPE==W25Q16)||(SPI_FLASH_TYPE==W25Q32)||(SPI_FLASH_TYPE==W25Q64)||(SPI_FLASH_TYPE==W25Q128))
	{
		SPI_Flash_Read((u8*)buff,0,sizeof(SysCfgDef));//地址0
		return 1;
	}
	else
	{
		return 0;
	}
	
}
 
u8 load_dev_cfg(DeviceDef *buff,u8 num)
{
	if ((SPI_FLASH_TYPE==W25Q80)||(SPI_FLASH_TYPE==W25Q16)||(SPI_FLASH_TYPE==W25Q32)||(SPI_FLASH_TYPE==W25Q64)||(SPI_FLASH_TYPE==W25Q128))
	{
		SPI_Flash_Read((u8*)buff,1024,sizeof(DeviceDef)*num);//地址0
		return 1;
	}
	else
	{
		return 0;
	}

}


u8 load_env_cfg(CtrllimitDef *buff,u8 num)
{
	if ((SPI_FLASH_TYPE==W25Q80)||(SPI_FLASH_TYPE==W25Q16)||(SPI_FLASH_TYPE==W25Q32)||(SPI_FLASH_TYPE==W25Q64)||(SPI_FLASH_TYPE==W25Q128))
	{
		SPI_Flash_Read((u8*)buff,2048,sizeof(CtrllimitDef)*num);//地址0
		return 1;
	}
	else
	{
		return 0;
	}

}







SysCfgDef *SYS_CFG=0;//系统配置
DeviceDef *DEV_CFG=0;//设备配置数组
CtrllimitDef *ENV_CFG=0;//环境配置数组
EnvirDef *ENV_VALUE=0;//采集器环境值

void sys_cfg_init(void)
{
	SYS_CFG=mymalloc(sizeof(SysCfgDef));
	load_sys_cfg(SYS_CFG);
	
	for (u16 i=0;i<sizeof(SysCfgDef);i++)
	{
		if (((u8*)SYS_CFG)[i]==0xff)
		{
			((u8*)SYS_CFG)[i]=0;
		}
	}
	if (SYS_CFG->numberOfDevices==0)
	{
		SYS_CFG->numberOfDevices=20;
	}
	
	if ((SYS_CFG->numberOfDevices<=20))//已经配置过，读取配置信息
	{
		DEV_CFG=mymalloc(sizeof(DeviceDef)*SYS_CFG->numberOfDevices);
		ENV_CFG=mymalloc(sizeof(CtrllimitDef)*SYS_CFG->numberOfDevices);
		load_dev_cfg(DEV_CFG,SYS_CFG->numberOfDevices);
		for (u16 i=0;i<sizeof(DeviceDef)*SYS_CFG->numberOfDevices;i++)
		{
			if (((u8*)DEV_CFG)[i]==0xff)
			{
				((u8*)DEV_CFG)[i]=0;
			}
		}
		for (u16 i=0;i<sizeof(CtrllimitDef)*SYS_CFG->numberOfDevices;i++)
		{
			if (((u8*)ENV_CFG)[i]==0xff)
			{
				((u8*)ENV_CFG)[i]=0;
			}
		}
	}
	if (SYS_CFG->ifUse==0)
	{
		SYS_CFG->numberOfDevices=0;
	}
	
	SYS_CFG->collectorNumber=get_collectorNumber();
	ENV_VALUE=mymalloc(sizeof(EnvirDef)*SYS_CFG->collectorNumber);//采集器环境值数组
	
	for (u16 i=0;i<sizeof(EnvirDef)*SYS_CFG->collectorNumber;i++)
	{
		if (((u8*)ENV_VALUE)[i]==0xff)
		{
			((u8*)ENV_VALUE)[i]=0;
		}
	}
	
}


u8 save_sys_cfg(SysCfgDef *buff)
{
	if ((SPI_FLASH_TYPE==W25Q80)||(SPI_FLASH_TYPE==W25Q16)||(SPI_FLASH_TYPE==W25Q32)||(SPI_FLASH_TYPE==W25Q64)||(SPI_FLASH_TYPE==W25Q128))
	{
		SPI_Flash_Write((u8*)buff,0,sizeof(SysCfgDef));//地址0
		return 1;
	}
	else
	{
		return 0;
	}
	
}


u8 save_dev_cfg(DeviceDef *buff,u8 num)
{
	if ((SPI_FLASH_TYPE==W25Q80)||(SPI_FLASH_TYPE==W25Q16)||(SPI_FLASH_TYPE==W25Q32)||(SPI_FLASH_TYPE==W25Q64)||(SPI_FLASH_TYPE==W25Q128))
	{
		SPI_Flash_Write((u8*)buff,1024,sizeof(DeviceDef)*num);//地址0
		return 1;
	}
	else
	{
		return 0;
	}

}


u8 save_env_cfg(CtrllimitDef *buff,u8 num)
{
	if ((SPI_FLASH_TYPE==W25Q80)||(SPI_FLASH_TYPE==W25Q16)||(SPI_FLASH_TYPE==W25Q32)||(SPI_FLASH_TYPE==W25Q64)||(SPI_FLASH_TYPE==W25Q128))
	{
		SPI_Flash_Write((u8*)buff,1024,sizeof(CtrllimitDef)*num);//地址0
		return 1;
	}
	else
	{
		return 0;
	}

}




			//获取系统配置
SysCfgDef *get_syscfg(void)
{
	return SYS_CFG;
}

			//获取指定位置的设备配置,在这里会进入总线中断？
DeviceDef *get_devcfg(u8 num)
{
	u8 *data=(u8 *)DEV_CFG;
	return (DeviceDef *)(data+sizeof(DeviceDef)*num);
}


			//获取指定地址的设备配置
DeviceDef *get_devcfgbyid(u16 id)
{
	for (u8 i=0;i<get_syscfg()->numberOfDevices;i++)
	{
		if (get_devcfg(i)->devId==id)
		{
			return get_devcfg(i);
		}
	}
	return 0;
}


			//获取指定位置的环境配置
CtrllimitDef *get_envcfg(u8 num)
{
	u8 *data=(u8 *)ENV_CFG;
	return (CtrllimitDef *)(data+sizeof(CtrllimitDef)*num);
}

			//获取采集器的数量
u8 get_collectorNumber(void)
{
	u8 collector_num=0;
	for (u8 i=0;i<get_syscfg()->numberOfDevices;i++)
	{
		if (get_devcfg(i)->devType==devTypeCJQ)
		{
			collector_num++;
		}
	}
	return collector_num;
}



			//获取指定类型设备的数量
u8 get_DevNumberByType(u8 devtype)
{
	u8 collector_num=0;
	for (u8 i=0;i<get_syscfg()->numberOfDevices;i++)
	{
		if (get_devcfg(i)->devType==devtype)
		{
			collector_num++;
		}
	}
	return collector_num;
}

//获取指定类型设备的状态
void get_DevStateByType(u8 devtype,u8 *offline,u8 *power,u8 *state)
{
	*offline=offlineYes;
	for (u8 i=0;i<get_syscfg()->numberOfDevices;i++)
	{
		if (get_devcfg(i)->devType==devtype)
		{
			*offline=get_devcfg(i)->offline;
			if (*offline==offlineNo)
			{
				*power=get_devcfg(i)->devPower;
				*state=get_devcfg(i)->devState;
				break;
			}
		}
	}
	if (*offline==offlineNo) return;
	if ((devtype==devTypeCS)||(devtype==devTypeJS))
	{
		for (u8 i=0;i<get_syscfg()->numberOfDevices;i++)
		{
			if (get_devcfg(i)->devType==devTypeYT)
			{
				if (*offline==offlineYes)
				{
					*offline=get_devcfg(i)->offline;
				}
				if (*offline==offlineNo)
				{
					*power=get_devcfg(i)->devPower;
					*state=get_devcfg(i)->devState;
				}
			}
		}
	}

}



//根据ID获取环境值结构体，在没有的情况下自动填充
EnvirDef *get_envirbyid (u16 devid)
{
	for (u8 i=0;i<get_syscfg()->collectorNumber;i++)
	{
		if (ENV_VALUE[i].collectorId==devid)
		{
			return &ENV_VALUE[i];
		}
		if (ENV_VALUE[i].collectorId==0)
		{
			ENV_VALUE[i].collectorId=devid;
			return &ENV_VALUE[i];
		}
	}
	return 0;
}

				//根据类型返回在线设备的地址列表
u8 get_OnLineDevIdListByType (u8 devtype,u16 *idbuff)
{
	u8 collector_num=0;
	for (u8 i=0;i<get_syscfg()->numberOfDevices;i++)
	{
		if (get_devcfg(i)->devType==devtype)
		{
			if (get_devcfg(i)->offline==offlineNo)
			{
				idbuff[collector_num]=get_devcfg(i)->devId;
				collector_num++;
			}
		}
	}
	return collector_num;
	
}
