yisea123/WK_JZQ_V2.7/HARDWARE/RELAY/relay.c

#include "includes.h"
#include "relay.h"


/*****************************************

			继电器控制IO口初始化

*****************************************/

void Relay_Init (void)
{
	GPIO_InitTypeDef  GPIO_InitStructure;

	RCC_APB2PeriphClockCmd(RCC_APB2Periph_GPIOB, ENABLE);	 //使能PB,PE端口时钟

	GPIO_InitStructure.GPIO_Pin = GPIO_Pin_2;				 //LED0-->PB.5 端口配置
	GPIO_InitStructure.GPIO_Mode = GPIO_Mode_Out_PP; 		 //推挽输出
	GPIO_InitStructure.GPIO_Speed = GPIO_Speed_2MHz;		 //IO口速度为50MHz
	GPIO_Init(GPIOB, &GPIO_InitStructure);					 //根据设定参数初始化GPIOB.5
	GPIO_SetBits(GPIOB,GPIO_Pin_2);						 //PB.5 输出高
	
}






void Relay_On (void)
{
	RELAY=0;
}
void Relay_Off (void)
{
	RELAY=1;
}
