yisea123/WK_JZQ_V2.7/MY_TASK/my_idle.h

#ifndef __MY_IDLE_H
#define __MY_IDLE_H



#ifdef __cplusplus
	extern "C" {
#endif




void idle_task(void *t);


u32 getIdleTask(void);

void getKilledTask(u32 *lasttime,u32 *dietimes,u8 pro);



#ifdef __cplusplus
	}
#endif




#endif
