yisea123/WK_JZQ_V2.7/(commit log)

2019-04-10 2019.4.10
    兼容以前的温控采集器
2019-04-16 2019.4.16
    调用任意函数
2019-04-18 2019.4.18
    修复一些一直bug
2019-04-19 2019.4.19
    加入上位机ping命令
2019-04-21 2019.4.21
    修改函数调用形式
2019-04-22 2019.4.22
    可以执行顺序结构的脚本，
2019-04-23 2019.4.23
    脚本支持数组 while 和 if
2019-04-24 2019.4.24
    脚本运行bug修复
2019-04-25 2019.4.25
    函数调用最大支持8个参数
    解决设置网关无效的bug
    加入子网掩码的设置
    加入服务器网络断线重启机制
2019-04-26 2019.4.26
    所有上位机消息加入集中器SN码字段
    使用c语言的随机数，每条发送消息都加一个cmdNum字段
2019-04-28 2019.4.28
    重写网络相关配置存储
    解决V2.3版键盘环绕灯指示异常的bug
    加入删除任务函数
2019-04-30 2019.4.30
    解决按键灯乱闪的bug
2019-05-05 2019.5.5
    初始化脚本
2019-05-07 2019.5.7
    加入大于小于判断，解决不等号判断结果异常的bug
    新增一些注释，做了一些程序结构的修改
2019-05-13 2019.5.13
    在用户程序中软件复位到ISP
2019-05-17 2019.5.17
    无接收地址为0的命令
2019-05-23 2019.5.23
    加入swd功能
2019-05-25 2019.5.25
    优化下载程序流程
2019-06-07 2019.6.7
    关屏时关灯带
2019-06-28 2019.6.27
    更改网口驱动
2019-07-11 2019.7.11
    离骚
2019-07-18 2019.7.18
    解决函数调用参数只有4个有效的bug
2019-07-19 2019.7.19
    程序优化
2019-07-21 2019.7.21
    添加播放指定旋律的功能，
    解决设置无线模块信道函数数组越界造成的无限重启bug
2019-07-22 2019.7.22
    实现读取文件播放蜂鸣器音乐
2019-07-23 2019.7.23
    可以串口调试
2019-07-25 2019.7.25
    加了一首菊花台
2019-08-01 任务上下文查询
    添加查询任务上下文的函数
    蜂鸣器驱动微调
    调试接口可以查询指定任务的上下文
2019-08-02 呼吸灯
    实现灯带呼吸灯效果
    解决软件定时器回调函数不回调的bug
    环境值正常时灯带绿色闪烁，环境值异常时灯带红色常亮
    无线查询到设备状态时更新集中器显示
2019-08-05 ping，蜂鸣器相关优化
    重写蜂鸣器播放驱动，使用两个定时器，一个计算时长，另一个调制输出频率
    降低CPU使用率，提高PWM调制精度
    ping操作可以直接ping 网址
    ping操作统计的延时精度提高到1ms
    字符串转数字函数在字符有非数字字符时转化值为0
    使用定时器5，提供1ms的定时器中断
