yisea123/WK_JZQ_V2.7/(notices)

Notices in the files:
HARDWARE/SD_CARD/MMC_SD.C:
Copyright(C) ¹ãÖÝÊÐÐÇÒíµç×Ó¿Æ¼¼ÓÐÏÞ¹«Ë¾ 2009-2019
All rights reserved
